Windfisch/wled-ethernet-box/(commit log)

2024-11-03 first attempt
    [case.scad]
2024-11-03 Add some tolerances
    [case.scad]
2024-11-03 Tune tolerances
    [case.scad]
2024-12-05 Improve design
    [case.scad]
